aotta/TA8-FDC/README.md

Forked and adapted from https://github.com/felge1966/Alphatronic-PC
Note: you have to solder the 50 pin bus connector on the solder side, since by mistake i mirrored odd & even pin in gerber
