aotta/TA8-FDC/(list of files, drawings)

Other design files:
TA8-FDC.dsn
