aotta/TA8-FDC/TA8-FDC.kicad_pcb

## KiCad design TA8-FDC.kicad_pcb (2024-02-15)

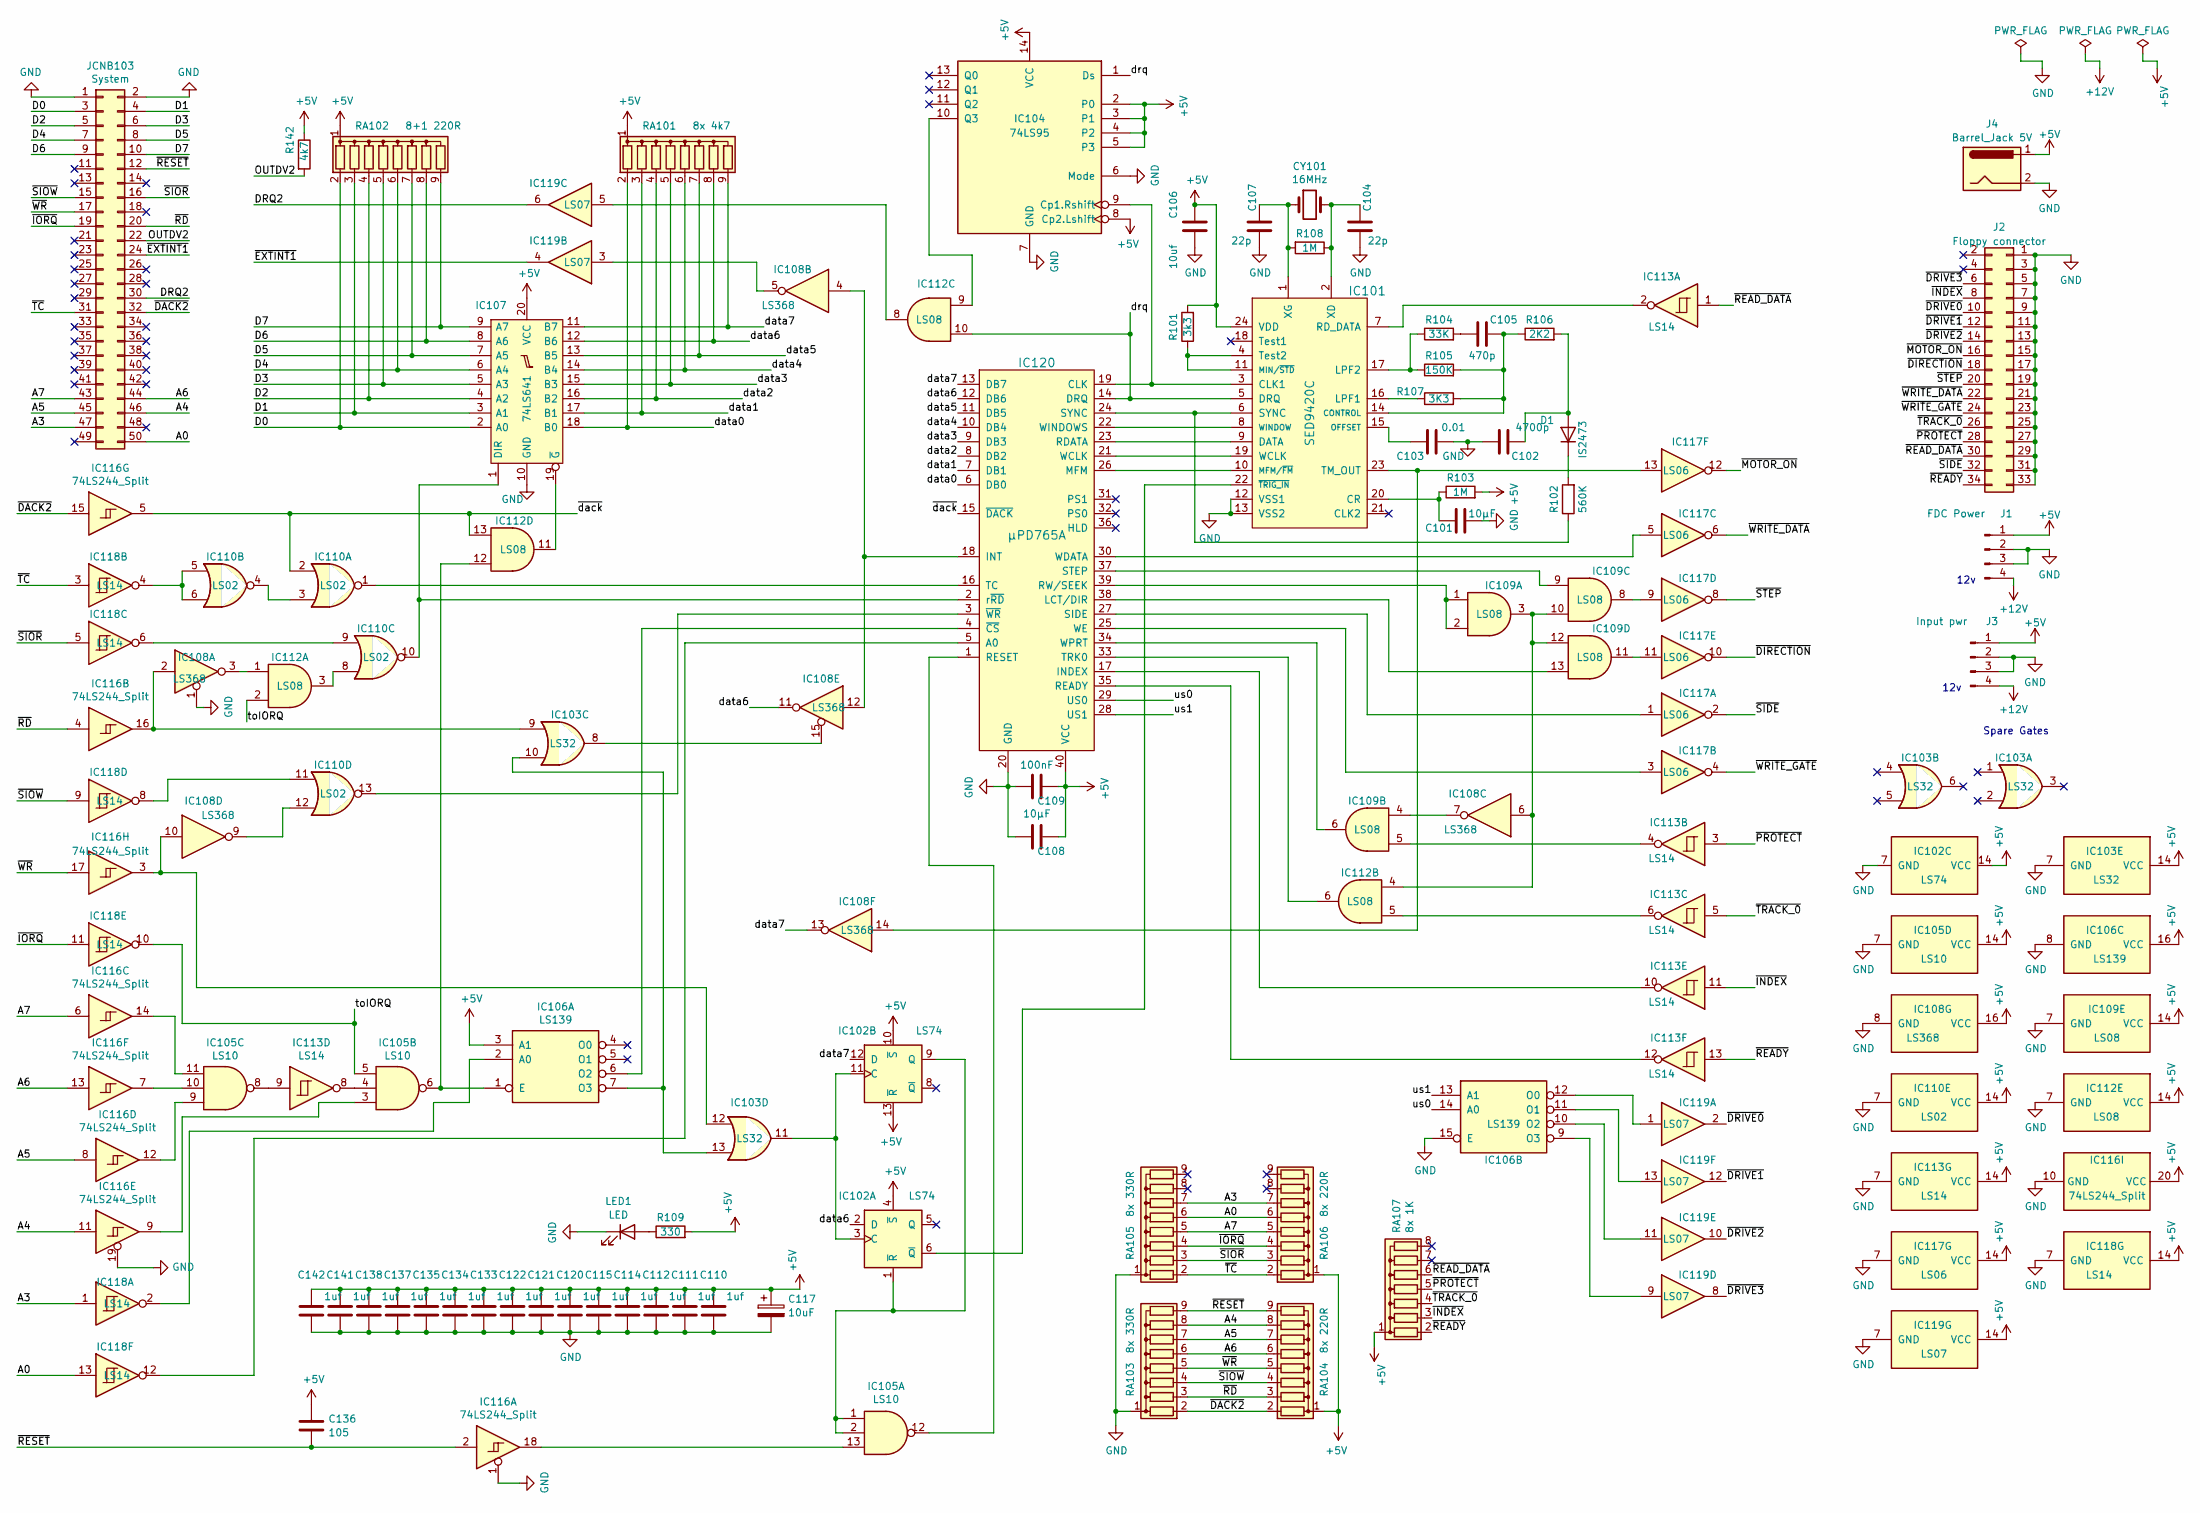
[picture p1: schematic TA8-FDC.kicad_sch, Alphatronic FDC replica]

Parts:
C101, C108: 10µF; CP_Axial_L10.0mm_D4.5mm_P15.00mm_Horizontal
C102: 4700p; C_Disc_D3.0mm_W2.0mm_P2.50mm
C103: 0.01; C_Disc_D3.0mm_W2.0mm_P2.50mm
C104, C107: 22p; C_Disc_D3.0mm_W2.0mm_P2.50mm
C105: 470p; C_Disc_D3.0mm_W2.0mm_P2.50mm
C106: 10uf; CP_Axial_L10.0mm_D4.5mm_P15.00mm_Horizontal
C109: 100nF; C_Disc_D3.0mm_W2.0mm_P2.50mm
C110, C111, C112, C114, C115, C120, C121, C122, C133, C134, C135, C137, C138, C141, C142: 1uf; C_Disc_D3.0mm_W2.0mm_P2.50mm
C117: 10uF; CP_Axial_L10.0mm_D4.5mm_P15.00mm_Horizontal
C136: 105; C_Axial_L3.8mm_D2.6mm_P7.50mm_Horizontal
CY101: 16MHz; Crystal_HC49-4H_Vertical
D1: IS2473; D_A-405_P10.16mm_Horizontal
IC101: SED9420C; DIP-24_W15.24mm
IC102: LS74; DIP-14_W7.62mm
IC103: LS32; DIP-14_W7.62mm
IC104: 74LS95; DIP-14_W7.62mm
IC105: LS10; DIP-14_W7.62mm
IC106: LS139; DIP-16_W7.62mm
IC107: 74LS641; DIP-20_W7.62mm
IC108: LS368; DIP-16_W7.62mm
IC109, IC112: LS08; DIP-14_W7.62mm
IC110: LS02; DIP-14_W7.62mm
IC113, IC118: LS14; DIP-14_W7.62mm
IC116: 74LS244_Split; DIP-20_W7.62mm
IC117: LS06; DIP-14_W7.62mm
IC119: LS07; DIP-14_W7.62mm
IC120: µPD765A; DIP-40_W15.24mm
J1: FDC Power; Molex_SL_171971-0004_1x04_P2.54mm_Vertical
J2: Floppy connector; IDC-Header_2x17_P2.54mm_Horizontal
J3: Input pwr; Molex_SL_171971-0004_1x04_P2.54mm_Vertical
J4: Barrel_Jack 5V; BarrelJack_Horizontal
JCNB103: System; PinSocket_2x25_P2.54mm_Horizontal
LED1: LED; LED_D3.0mm
R101: 3k3; R_Axial_DIN0207_L6.3mm_D2.5mm_P10.16mm_Horizontal
R102: 560K; R_Axial_DIN0207_L6.3mm_D2.5mm_P10.16mm_Horizontal
R103, R108: 1M; R_Axial_DIN0207_L6.3mm_D2.5mm_P10.16mm_Horizontal
R104: 33K; R_Axial_DIN0207_L6.3mm_D2.5mm_P10.16mm_Horizontal
R105: 150K; R_Axial_DIN0207_L6.3mm_D2.5mm_P10.16mm_Horizontal
R106: 2K2; R_Axial_DIN0207_L6.3mm_D2.5mm_P10.16mm_Horizontal
R107: 3K3; R_Axial_DIN0207_L6.3mm_D2.5mm_P10.16mm_Horizontal
R109: 330; R_Axial_DIN0207_L6.3mm_D2.5mm_P10.16mm_Horizontal
R142: 4k7; R_Axial_DIN0207_L6.3mm_D2.5mm_P10.16mm_Horizontal
RA101: 8x 4k7; R_Array_SIP9
RA102: 8+1 220R; R_Array_SIP9
RA103, RA105: 8x 330R; R_Array_SIP9
RA104, RA106: 8x 220R; R_Array_SIP9
RA107: 8x 1K; R_Array_SIP8

Connections:
+5V: C106.1, C108.1, C109.1, C110.2, C111.2, C112.2, C114.2, C115.2, C117.1, C120.2, C121.2, C122.2, C133.2, C134.2, C135.2, C136.2, C137.2, C138.2, C141.2, C142.2, IC101.24 (VDD), IC102.4 (~S), IC102.10 (~S), IC102.13 (~R), IC102.14 (VCC), IC103.14 (VCC), IC104.2 (P0), IC104.3 (P1), IC104.4 (P2), IC104.5 (P3), IC104.8 (Cp2.Lshift), IC104.14 (VCC), IC105.14 (VCC), IC106.3 (A1), IC106.16 (VCC), IC107.20 (VCC), IC108.16 (VCC), IC109.14 (VCC), IC110.14 (VCC), IC112.14 (VCC), IC113.14 (VCC), IC116.20 (VCC), IC117.14 (VCC), IC118.14 (VCC), IC119.14 (VCC), IC120.40 (VCC), J1.1, J3.1, J4.1, R101.2, R103.2, R109.2, R142.1, RA101.1 (common), RA102.1 (common), RA104.1 (common), RA106.1 (common), RA107.1 (common)
+12V: J1.4, J3.4
/A0: IC118.13, JCNB103.50, RA105.6 (R5), RA106.6 (R5)
/A3: IC118.1, JCNB103.47, RA105.7 (R6), RA106.7 (R6)
/A4: IC116.11, JCNB103.46, RA103.8 (R7), RA104.8 (R7)
/A5: IC116.8, JCNB103.45, RA103.7 (R6), RA104.7 (R6)
/A6: IC116.13, JCNB103.44, RA103.6 (R5), RA104.6 (R5)
/A7: IC116.6, JCNB103.43, RA105.5 (R4), RA106.5 (R4)
/D0: IC107.2 (A0), JCNB103.3, RA102.2 (R1)
/D1: IC107.3 (A1), JCNB103.4, RA102.3 (R2)
/D2: IC107.4 (A2), JCNB103.5, RA102.4 (R3)
/D3: IC107.5 (A3), JCNB103.6, RA102.5 (R4)
/D4: IC107.6 (A4), JCNB103.7, RA102.6 (R5)
/D5: IC107.7 (A5), JCNB103.8, RA102.7 (R6)
/D6: IC107.8 (A6), JCNB103.9, RA102.8 (R7)
/D7: IC107.9 (A7), JCNB103.10, RA102.9 (R8)
/DRQ2: IC119.6, JCNB103.30
/OUTDV2: JCNB103.22, R142.2
/data0: IC107.18 (B0), IC120.6 (DB0), RA101.2 (R1)
/data1: IC107.17 (B1), IC120.7 (DB1), RA101.3 (R2)
/data2: IC107.16 (B2), IC120.8 (DB2), RA101.4 (R3)
/data3: IC107.15 (B3), IC120.9 (DB3), RA101.5 (R4)
/data4: IC107.14 (B4), IC120.10 (DB4), RA101.6 (R5)
/data5: IC107.13 (B5), IC120.11 (DB5), RA101.7 (R6)
/data6: IC102.2 (D), IC107.12 (B6), IC108.11, IC120.12 (DB6), RA101.8 (R7)
/data7: IC102.12 (D), IC107.11 (B7), IC108.13, IC120.13 (DB7), RA101.9 (R8)
/drq: IC101.5 (DRQ), IC104.1 (Ds), IC112.10, IC120.14 (DRQ)
/toIORQ: IC105.5, IC112.2, IC118.10
/us0: IC106.14 (A0), IC120.29 (US0)
/us1: IC106.13 (A1), IC120.28 (US1)
/~DACK2: IC116.15, JCNB103.32, RA103.2 (R1), RA104.2 (R1)
/~DIRECTION: IC117.10, J2.18
/~DRIVE0: IC119.2, J2.10
/~DRIVE1: IC119.12, J2.12
/~DRIVE2: IC119.10, J2.14
/~DRIVE3: IC119.8, J2.6
/~EXTINT1: IC119.4, JCNB103.24
/~INDEX: IC113.11, J2.8, RA107.3 (R2)
/~IORQ: IC118.11, JCNB103.19, RA105.4 (R3), RA106.4 (R3)
/~MOTOR_ON: IC117.12, J2.16
/~PROTECT: IC113.3, J2.28, RA107.5 (R4)
/~RD: IC116.4, JCNB103.20, RA103.3 (R2), RA104.3 (R2)
/~READY: IC113.13, J2.34, RA107.2 (R1)
/~READ_DATA: IC113.1, J2.30, RA107.6 (R5)
/~RESET: C136.1, IC116.2, JCNB103.12, RA103.9 (R8), RA104.9 (R8)
/~SIDE: IC117.2, J2.32
/~SIOR: IC118.5, JCNB103.16, RA105.3 (R2), RA106.3 (R2)
/~SIOW: IC118.9, JCNB103.15, RA103.4 (R3), RA104.4 (R3)
/~STEP: IC117.8, J2.20
/~TC: IC118.3, JCNB103.31, RA105.2 (R1), RA106.2 (R1)
/~TRACK_0: IC113.5, J2.26, RA107.4 (R3)
/~WRITE_DATA: IC117.6, J2.22
/~WRITE_GATE: IC117.4, J2.24
/~WR: IC116.17, JCNB103.17, RA103.5 (R4), RA104.5 (R4)
/~dack: IC110.2, IC112.13, IC116.5, IC120.15 (~DACK)
GND: C101.2, C102.1, C103.2, C104.2, C106.2, C107.2, C108.2, C109.2, C110.1, C111.1, C112.1, C114.1, C115.1, C117.2, C120.1, C121.1, C122.1, C133.1, C134.1, C135.1, C137.1, C138.1, C141.1, C142.1, IC101.12 (VSS1), IC101.13 (VSS2), IC102.7 (GND), IC103.7 (GND), IC104.6 (Mode), IC104.7 (GND), IC105.7 (GND), IC106.8 (GND), IC106.15 (E), IC107.10 (GND), IC108.1, IC108.8 (GND), IC109.7 (GND), IC110.7 (GND), IC112.7 (GND), IC113.7 (GND), IC116.1, IC116.10 (GND), IC116.19, IC117.7 (GND), IC118.7 (GND), IC119.7 (GND), IC120.20 (GND), J1.2, J1.3, J2.1, J2.3, J2.5, J2.7, J2.9, J2.11, J2.13, J2.15, J2.17, J2.19, J2.21, J2.23, J2.25, J2.27, J2.29, J2.31, J2.33, J3.2, J3.3, J4.2, JCNB103.1, JCNB103.2, LED1.1 (K), RA103.1 (common), RA105.1 (common)
unnamed: C105.1, R104.2
unnamed: C102.2, D1.2 (A), R106.2
unnamed: D1.1 (K), R102.2
unnamed: IC101.3 (CLK1), IC104.9 (Cp1.Rshift), IC120.19 (CLK)
unnamed: C105.2, IC101.14 (CONTROL), R105.2, R106.1, R107.2
unnamed: C101.1, IC101.20 (CR), R103.1
unnamed: IC101.9 (DATA), IC120.23 (RDATA)
unnamed: IC101.16 (LPF1), R107.1
unnamed: IC101.17 (LPF2), R104.1, R105.1
unnamed: IC101.10 (MFM/~FM), IC120.26 (MFM)
unnamed: IC101.4 (Test2), IC101.11 (MIN/~STD), R101.1
unnamed: C103.1, IC101.15 (OFFSET)
unnamed: IC101.7 (RD_DATA), IC113.2
unnamed: IC101.6 (SYNC), IC120.24 (SYNC), R102.1
unnamed: IC101.23 (TM_OUT), IC108.14, IC117.13
unnamed: IC101.19 (WCLK), IC120.21 (WCLK)
unnamed: IC101.8 (WINDOW), IC120.22 (WINDOWS)
unnamed: C104.1, CY101.2, IC101.2 (XD), R108.1
unnamed: C107.1, CY101.1, IC101.1 (XG), R108.2
unnamed: IC101.22 (~TRIG_IN), IC102.6 (~Q)
unnamed: IC102.3 (C), IC102.11 (C), IC103.11
unnamed: IC102.1 (~R), IC102.9 (Q), IC105.1, IC105.2
unnamed: IC103.8, IC108.15
unnamed: IC103.9, IC108.2, IC116.16
unnamed: IC103.12, IC108.10, IC116.3
unnamed: IC104.10 (Q3), IC112.9
unnamed: IC105.3, IC116.9
unnamed: IC105.4, IC113.8
unnamed: IC105.8, IC113.9
unnamed: IC105.9, IC116.12
unnamed: IC105.10, IC116.7
unnamed: IC105.11, IC116.14
unnamed: IC105.13, IC116.18
unnamed: IC106.2 (A0), IC118.2
unnamed: IC105.6, IC106.1 (E), IC112.12
unnamed: IC106.6 (O2), IC120.4 (~CS)
unnamed: IC103.10, IC103.13, IC106.7 (O3)
unnamed: IC106.12 (O0), IC119.1
unnamed: IC106.11 (O1), IC119.13
unnamed: IC106.10 (O2), IC119.11
unnamed: IC106.9 (O3), IC119.9
unnamed: IC107.1 (DIR), IC110.10, IC120.2 (r~RD)
unnamed: IC107.19 (~G), IC112.11
unnamed: IC108.3, IC112.1
unnamed: IC108.5, IC119.3
unnamed: IC108.6, IC109.3, IC109.10, IC109.12, IC112.4
unnamed: IC108.7, IC109.4
unnamed: IC108.9, IC110.12
unnamed: IC109.5, IC113.4
unnamed: IC109.8, IC117.9
unnamed: IC109.11, IC117.11
unnamed: IC110.3, IC110.4
unnamed: IC110.5, IC110.6, IC118.4
unnamed: IC110.8, IC112.3
unnamed: IC110.9, IC118.6
unnamed: IC110.11, IC118.8
unnamed: IC112.5, IC113.6
unnamed: IC112.8, IC119.5
unnamed: IC118.12, IC120.5 (A0)
unnamed: IC113.10, IC120.17 (INDEX)
unnamed: IC108.4, IC108.12, IC120.18 (INT)
unnamed: IC109.13, IC120.38 (LCT/DIR)
unnamed: IC113.12, IC120.35 (READY)
unnamed: IC105.12, IC120.1 (RESET)
unnamed: IC109.1, IC109.2, IC120.39 (RW/SEEK)
unnamed: IC117.1, IC120.27 (SIDE)
unnamed: IC109.9, IC120.37 (STEP)
unnamed: IC110.1, IC120.16 (TC)
unnamed: IC112.6, IC120.33 (TRK0)
unnamed: IC117.5, IC120.30 (WDATA)
unnamed: IC117.3, IC120.25 (WE)
unnamed: IC109.6, IC120.34 (WPRT)
unnamed: IC110.13, IC120.3 (~WR)
unnamed: LED1.2 (A), R109.1

Notes on the sheet:
Spare Gates
12v

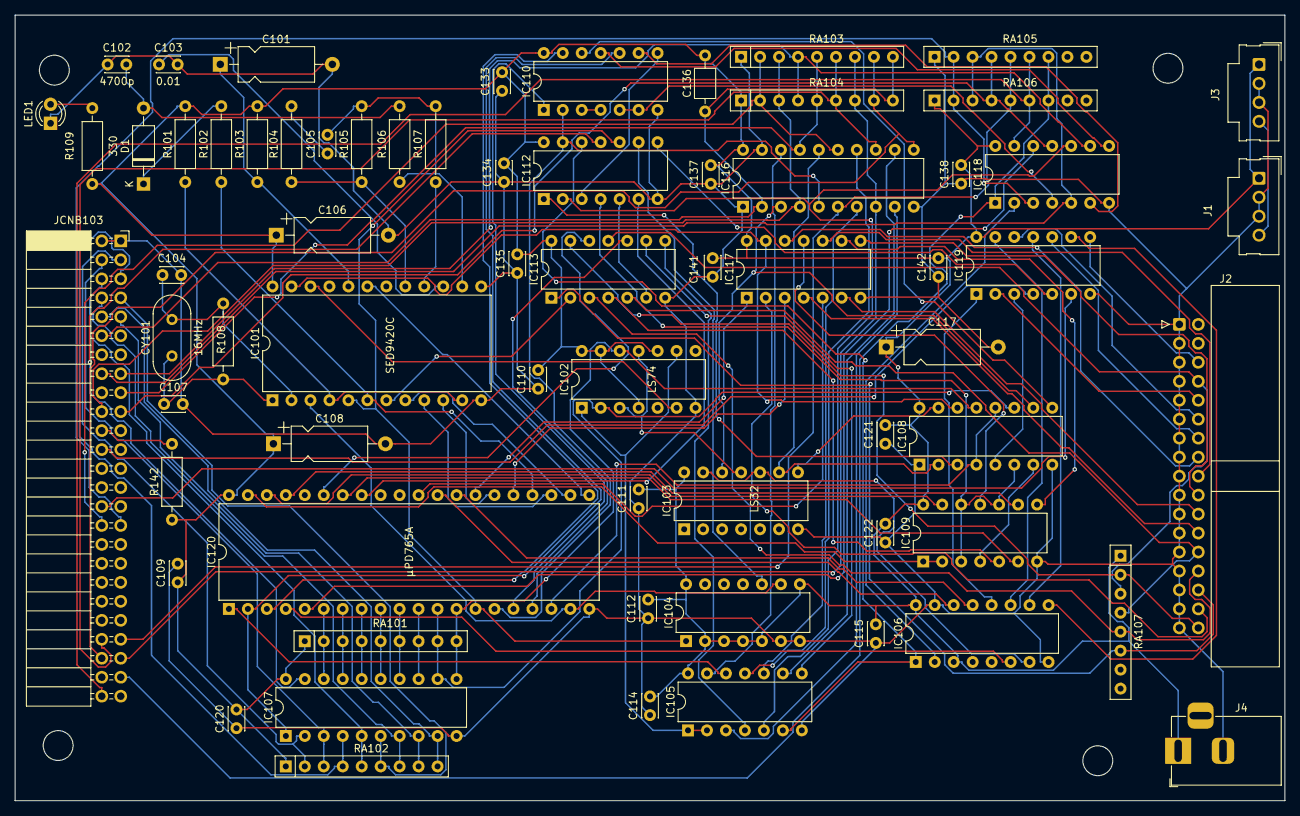
[picture p2: board TA8-FDC.kicad_pcb from above]

Board: 2 copper layers, 170.0 x 105.2 mm, 68 parts (0 on the bottom side), 130 nets.
