aotta/TA8-FDC/(commit log)

2023-12-30 Add files via upload
    initial load
    [TA8-FDC.csv, TA8-FDC.dsn, TA8-FDC.kicad_pcb, TA8-FDC.kicad_sch, TA8-FDC.sch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]
2024-01-02 Add files via upload
    corrected a couple of error on schematics
    [TA8-FDC.dsn, TA8-FDC.kicad_pcb, TA8-FDC.kicad_sch]
2024-02-15 Fixed C117
    [TA8-FDC.kicad_pcb, TA8-FDC.kicad_sch]
